allen981128-gif/esp32-s3-Environmental-sensor/docs/website_page.jpg

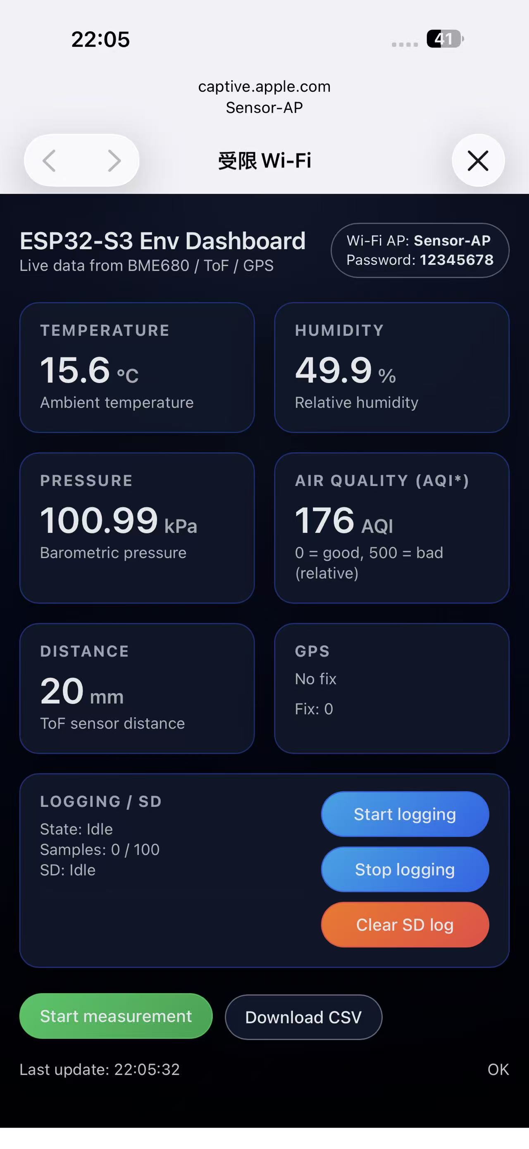
docs/website_page.jpg
