allen981128-gif/esp32-s3-Environmental-sensor/docs/Enviromental_Sensor.jpg

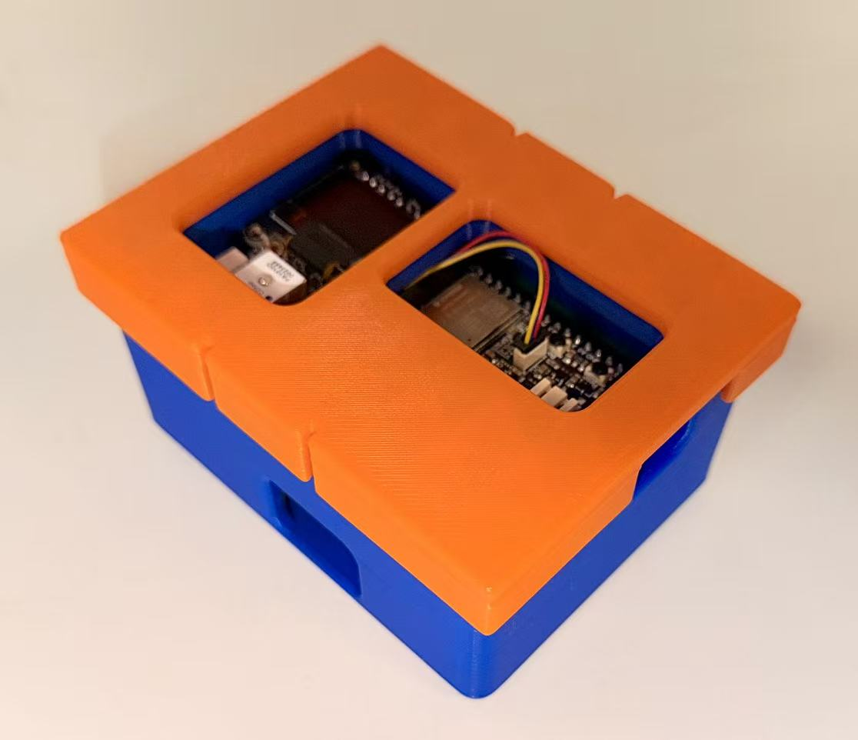
docs/Enviromental_Sensor.jpg
