allen981128-gif/esp32-s3-Environmental-sensor/docs/Dataflow_Diagram.png

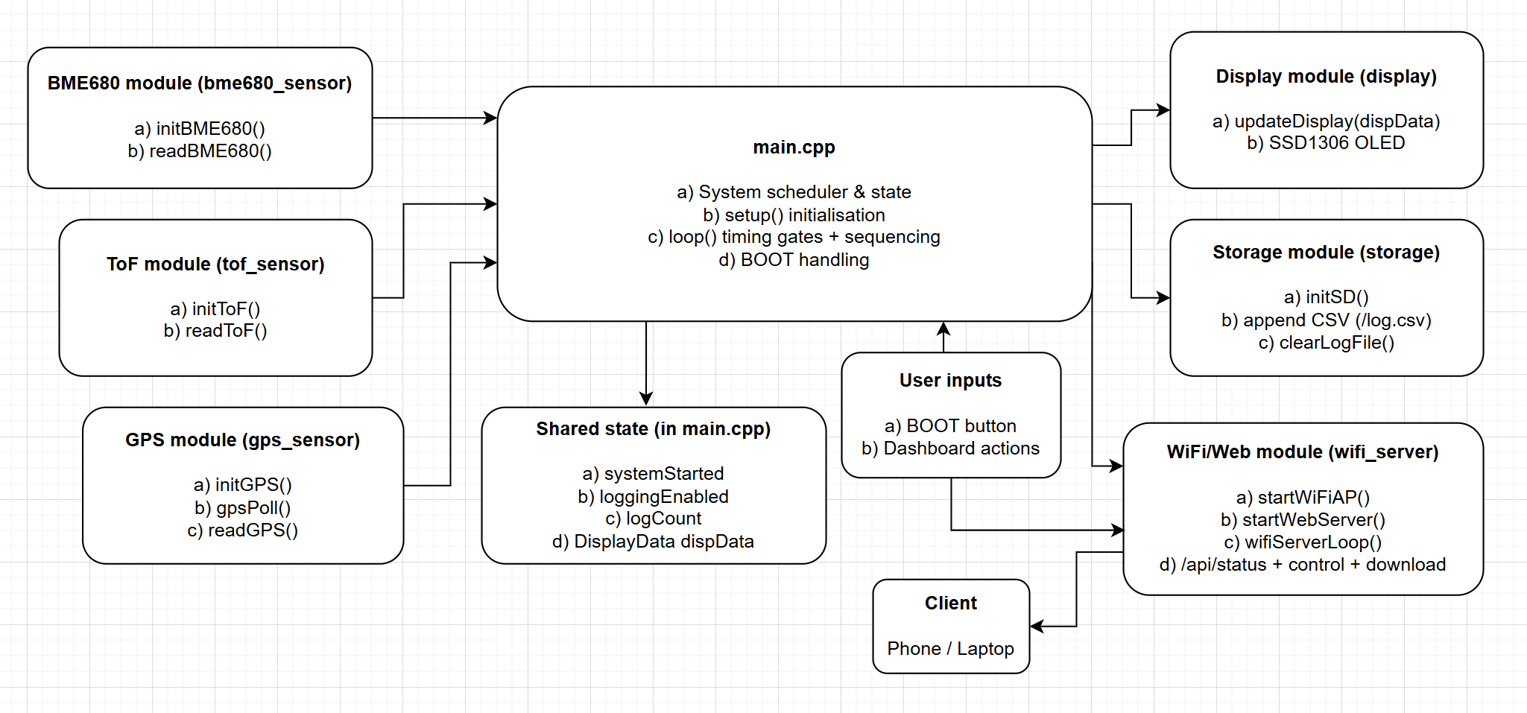
docs/Dataflow_Diagram.png
