allen981128-gif/esp32-s3-Environmental-sensor/docs/welcom_page_on_OLED.jpg

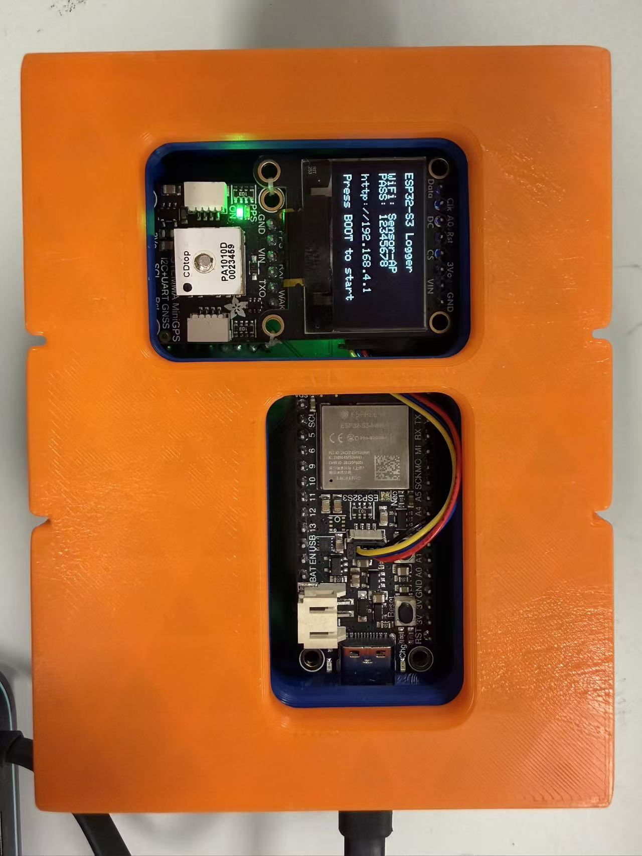
docs/welcom_page_on_OLED.jpg
