allen981128-gif/esp32-s3-Environmental-sensor/(list of files, drawings)

Other design files:
firmware/Enviroment（revision）.eprj
