allen981128-gif/esp32-s3-Environmental-sensor/include/bme680_sensor.h

#pragma once
#include <Arduino.h>

// Structure to store BME680 sensor readings
struct BME680Data {
    float temperature;
    float humidity;
    float pressure;
    float gas;
};

// Initialize BME680 module
bool initBME680();

// Read temperature, humidity, pressure, and gas resistance
BME680Data readBME680();
