allen981128-gif/esp32-s3-Environmental-sensor/(commit log)

2025-12-15 Add firmware, libraries, docs, and update gitignore
    [Enviroment（revision）.eprj]
2026-03-10 使用 Colab 创建而成
